akakoziqi/cwFOC/controller/README.md

# cwFOC 软件工程

## 环境搭建

开源环境搭建请参考 [这里](Docs/env.md)

## 结构划分

``` txt
build -------------- 编译中间文件（构建生成）
build_exec --------- 编译输出（构建生成）
Core --------------- 核心代码分层
    app ---------------- 应用层代码
    api ---------------- 接口层代码
    drv ---------------- 驱动层代码
    sys ---------------- 框架搭建中间层
    utl ---------------- 实用工具
Docs --------------- 相关文档
Debug -------------- 调试配置（自行获取）
Libraries ---------- MCU 驱动库（自行获取）
ThirdParty_Lib ----- 第三方库（自行获取）
```

## 调试方式

使用 pyOCD 调试
