akakoziqi/cwFOC/assets/cwFOC_sch.pdf

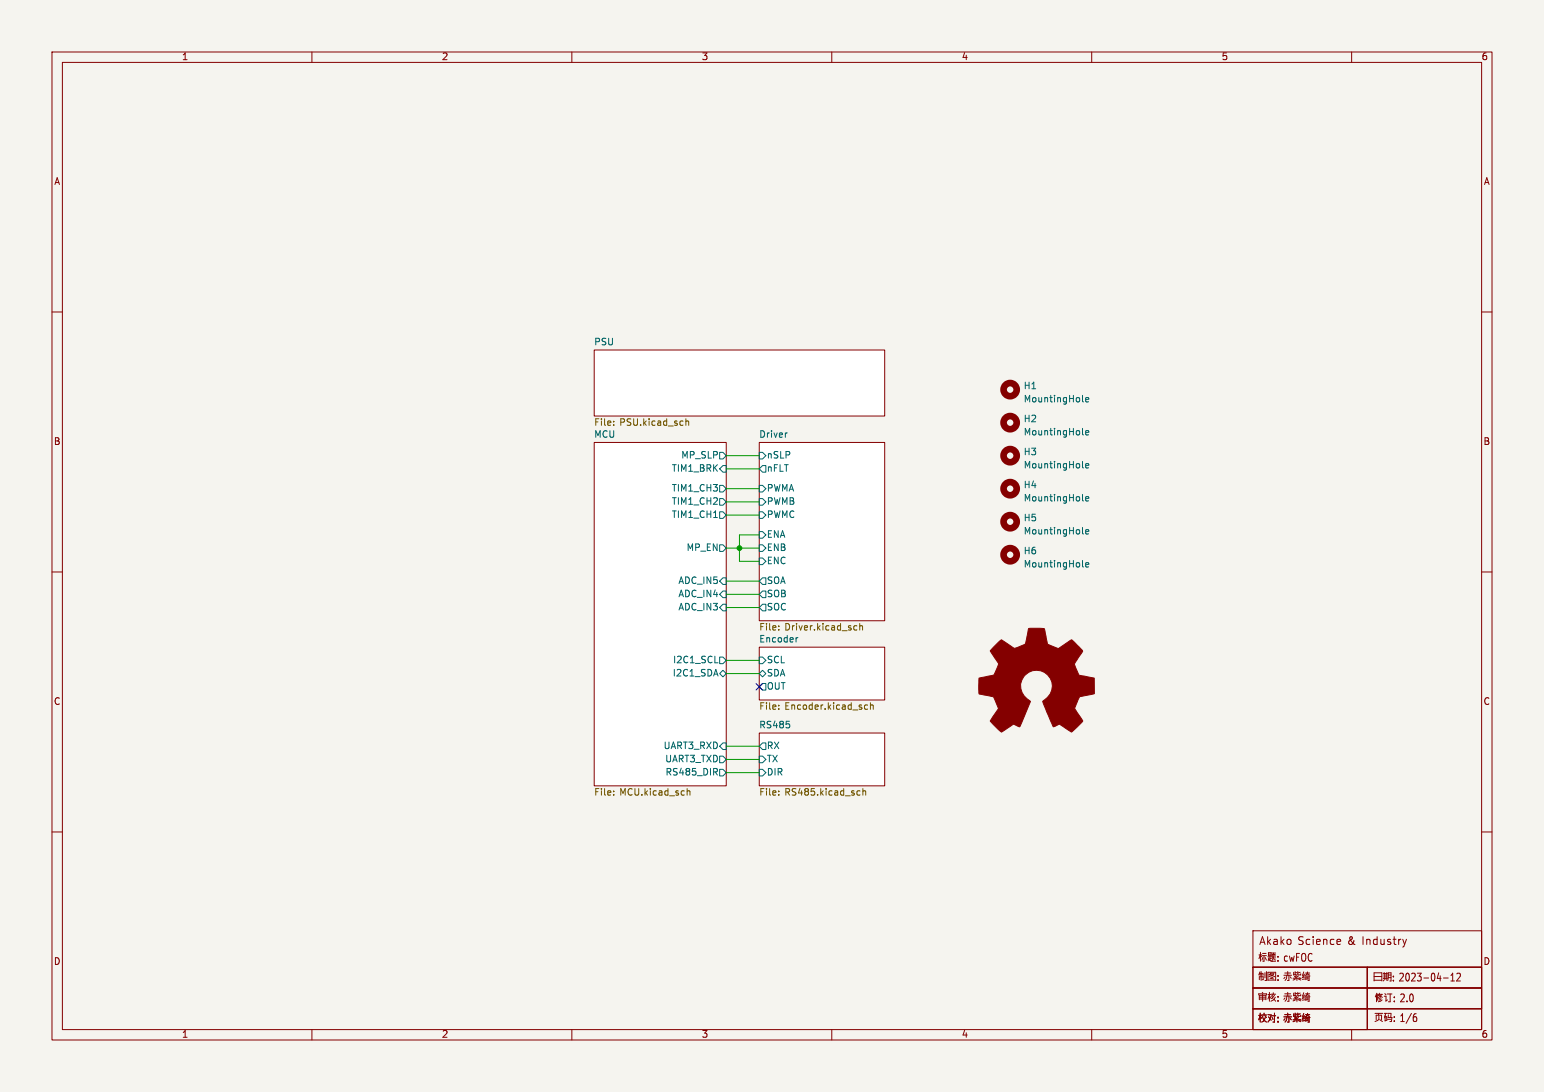
[picture p2: page 1]

RS485 File: RS485.kicad_sch OUT SCL SDA

þÿOî‹¢:2.0
þÿ˜ux:1/6

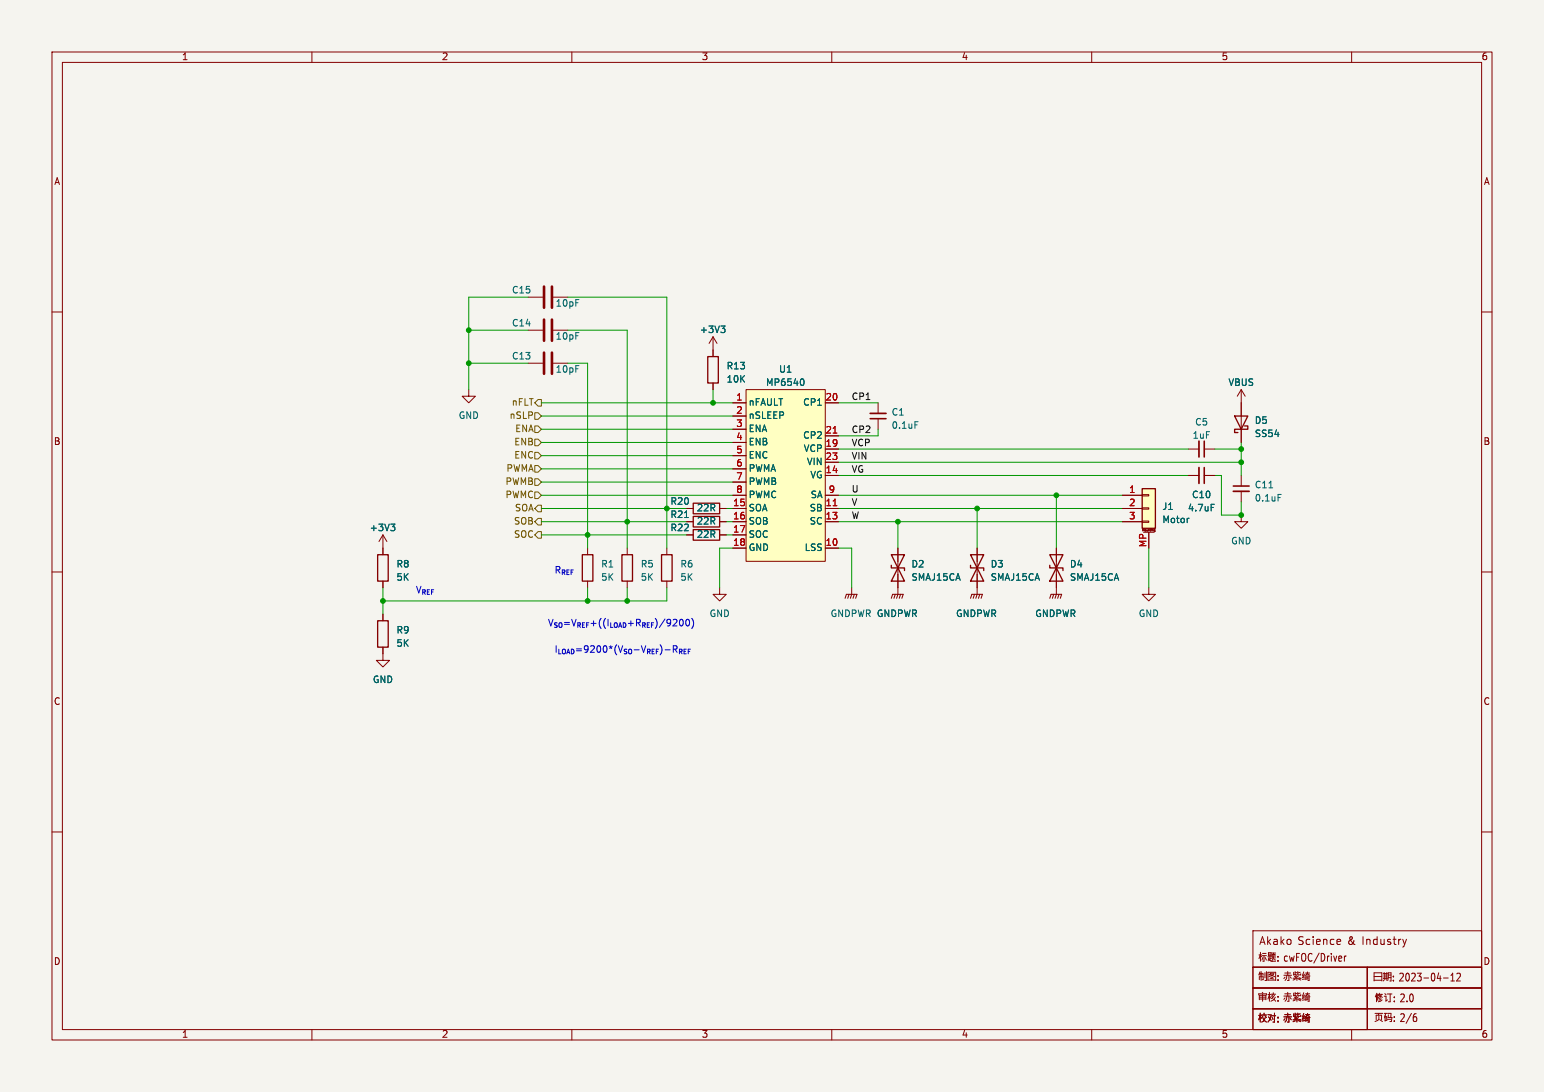
[picture p3: page 2]

22R | nSLEEP 2 ENA 3 ENB 4 ENC 5 PWMA 6 R21

2 2 | Mounting 1

V_{SO}=V_{REF}+((I_{LOAD}+R_{REF})/9200)

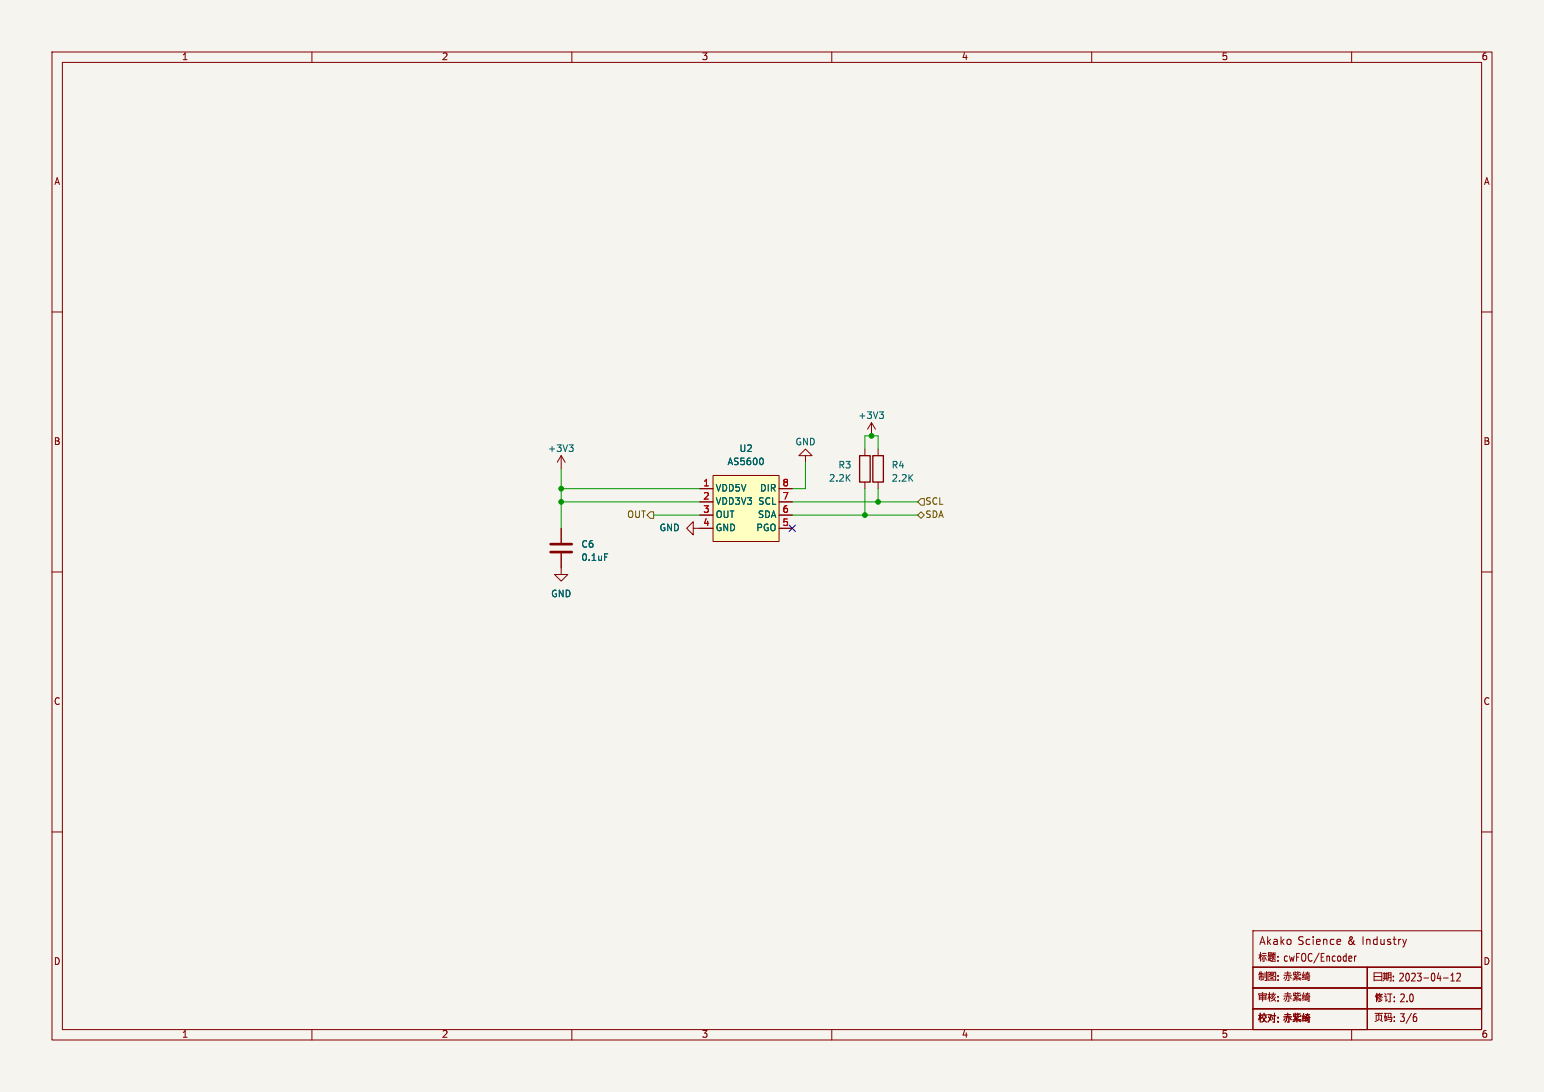
[picture p4: page 3]

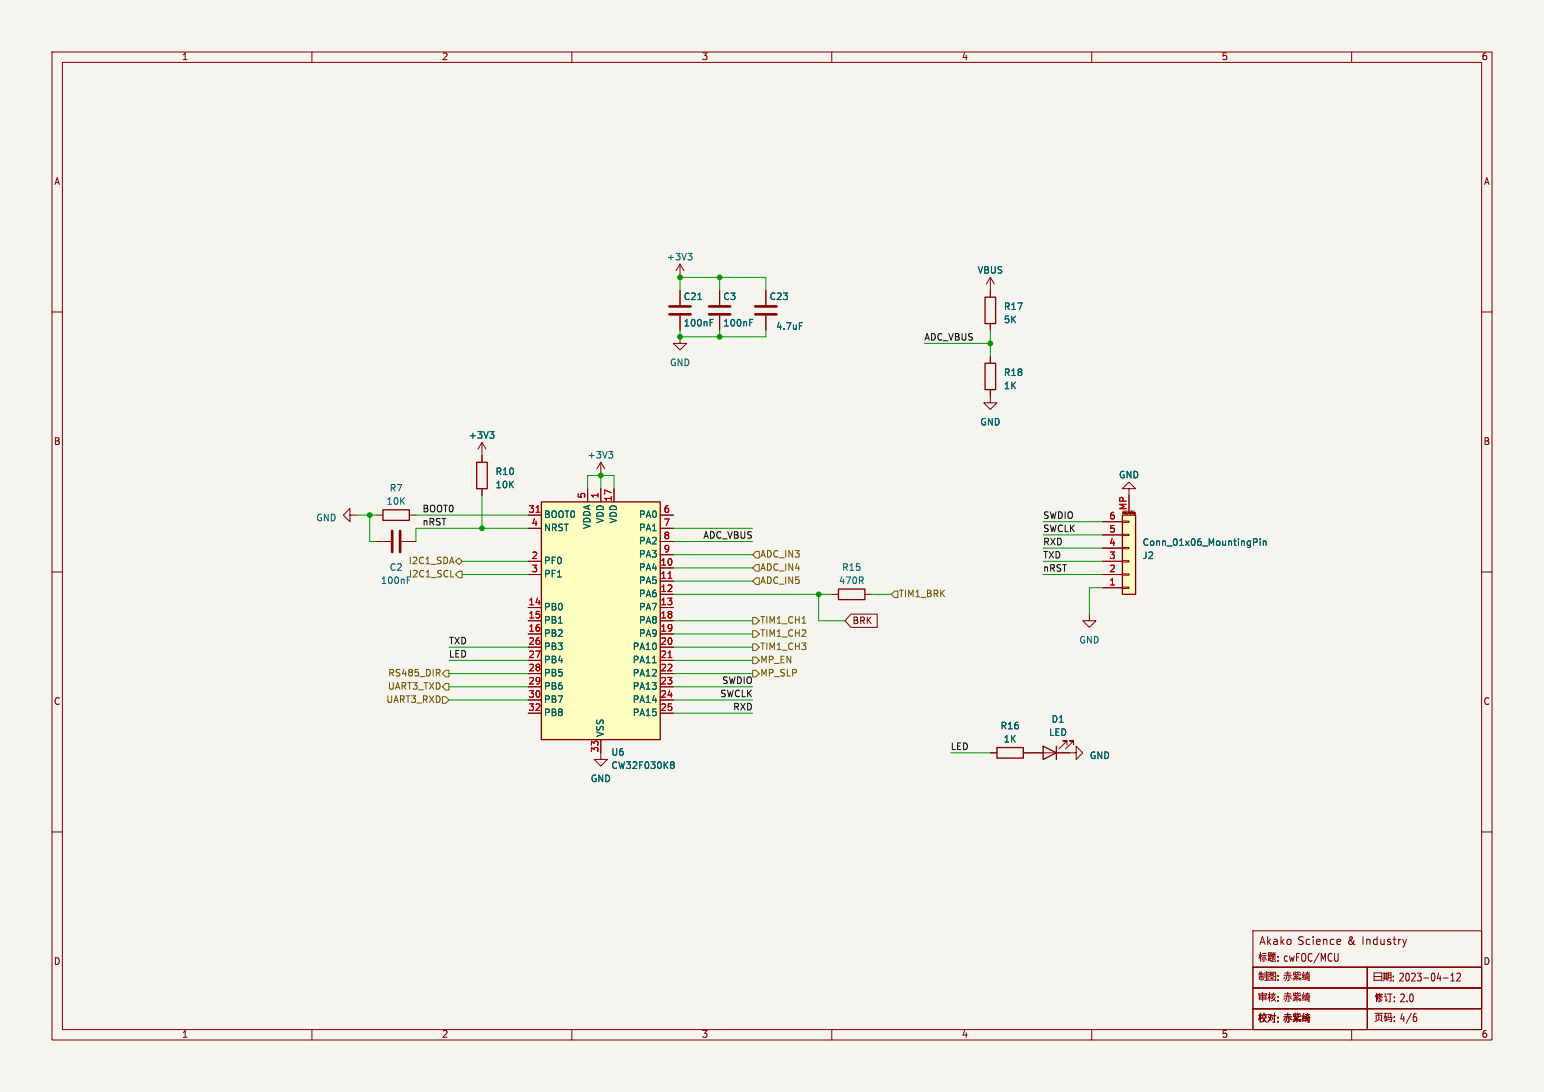
[picture p5: page 4]

1 PA4 10 PA5 11 PA6 12 PA7 13 PB0 14 PB1 15 PB2 16 VDD 17 PA8 18 PA9 19 PF0 2 PA10 20 PA11 21 PA12 22 PA13 23 PA14 24 PA15 25 PB3 26 PB4 27 PB5 28 PB6 29 PF1 3 PB7 30 BOOT0 31 PB8 32 VSS 33 NRST 4 VDDA

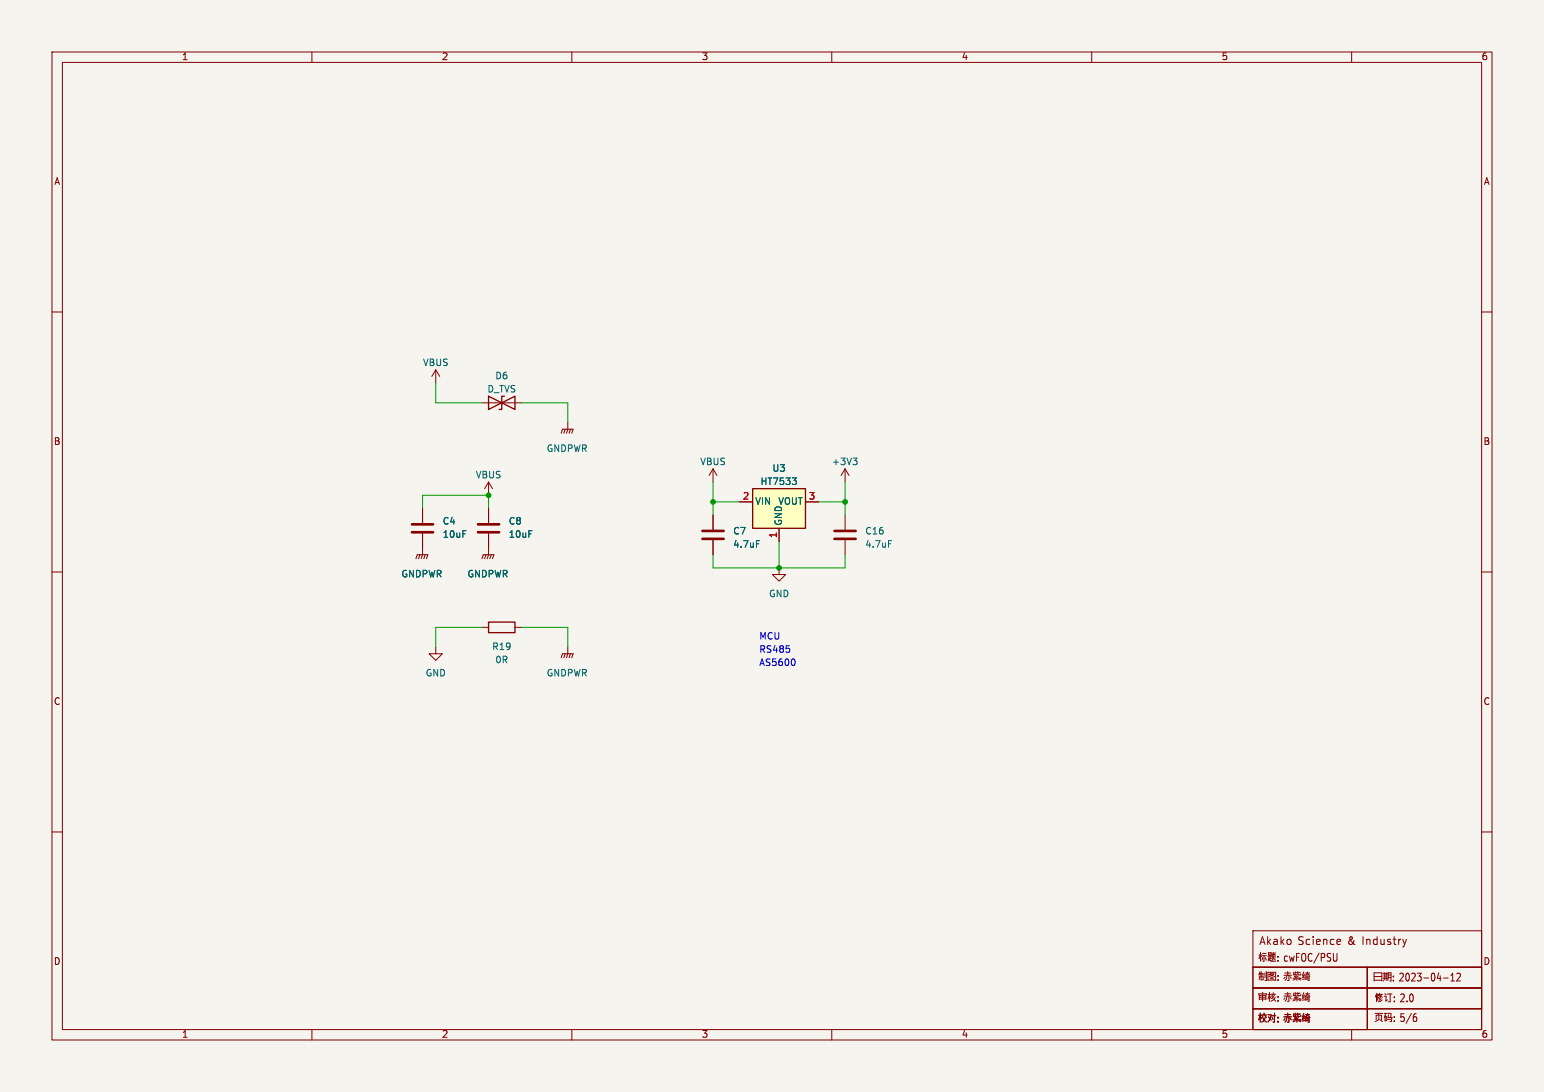
[picture p6: page 5]

1 VIN 2 VOUT 3 GNDPWR GNDPWR

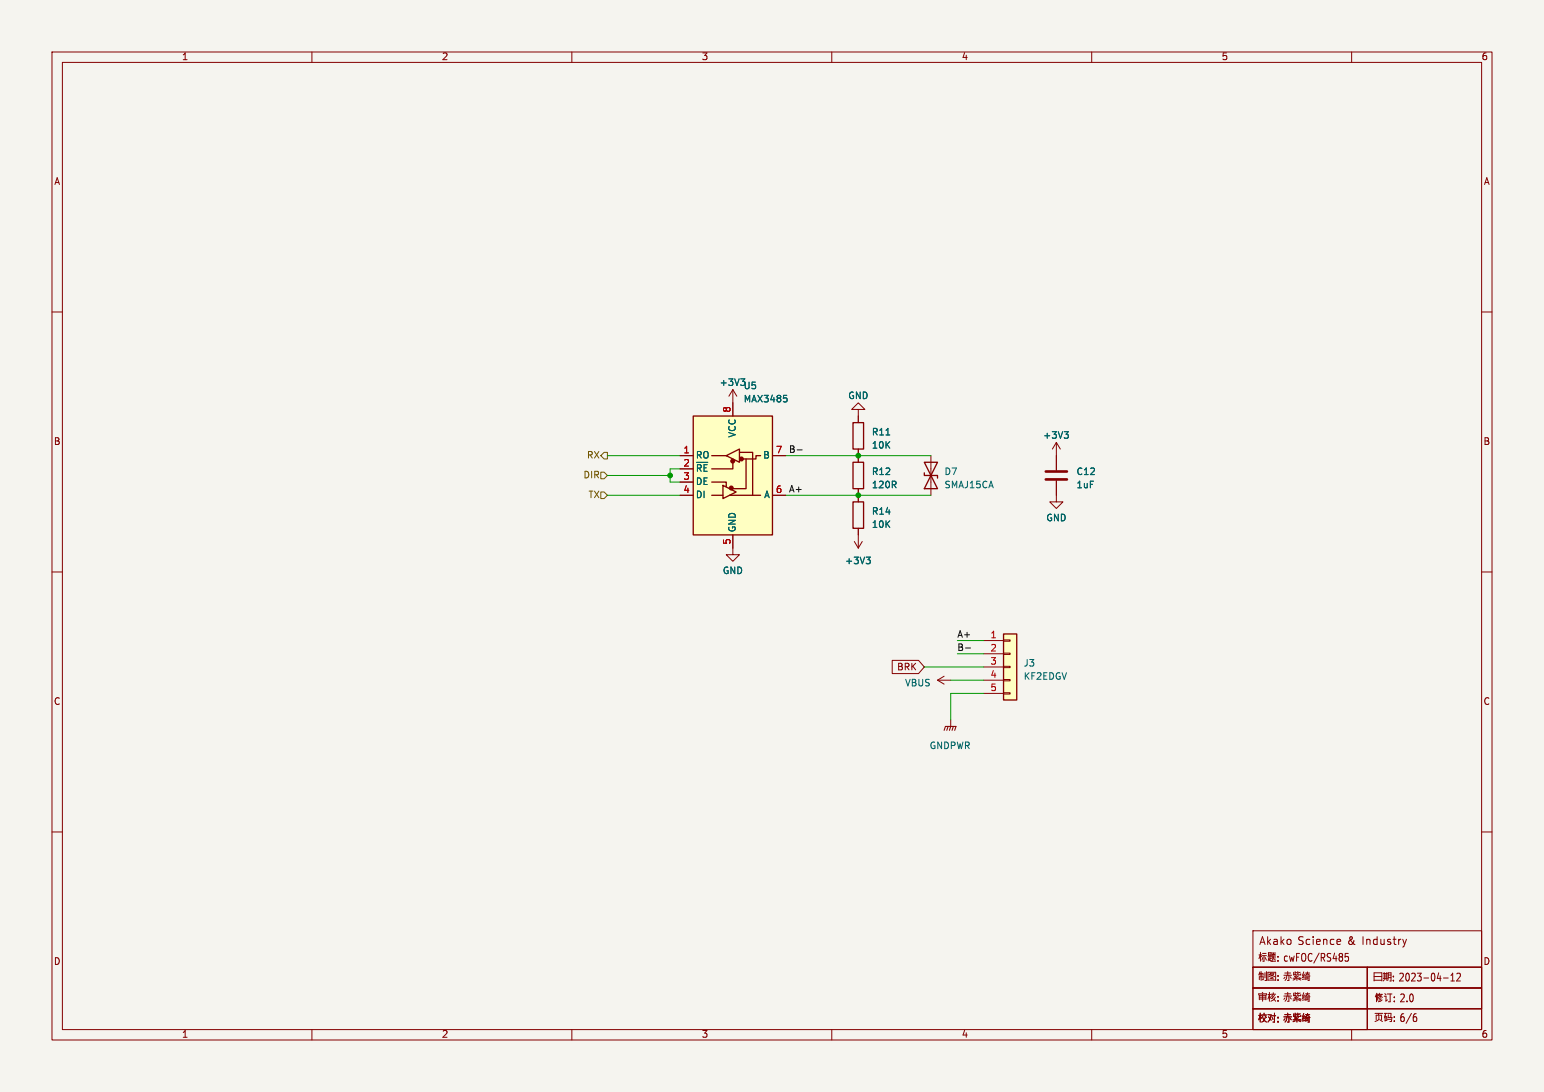
[picture p7: page 6]
