akakoziqi/cwFOC/Hardware/cwFOC.kicad_pcb

## KiCad design Hardware/cwFOC.kicad_pcb (2023-04-12)

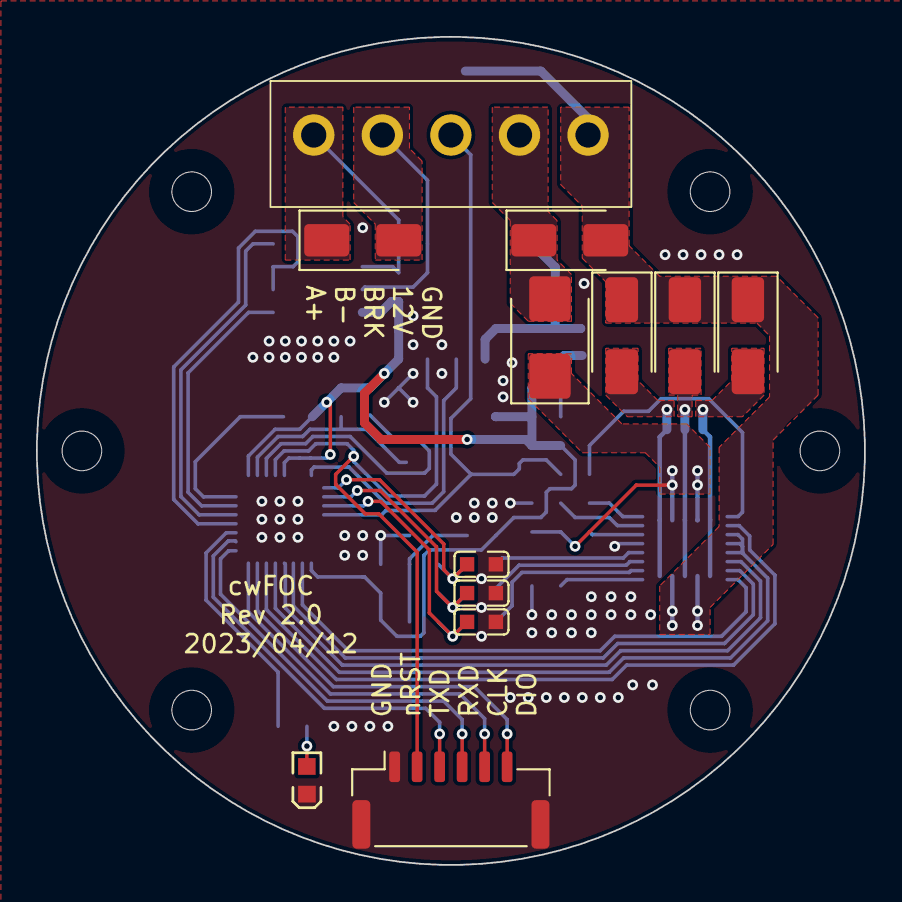
[picture p8: board cwFOC.kicad_pcb from above]

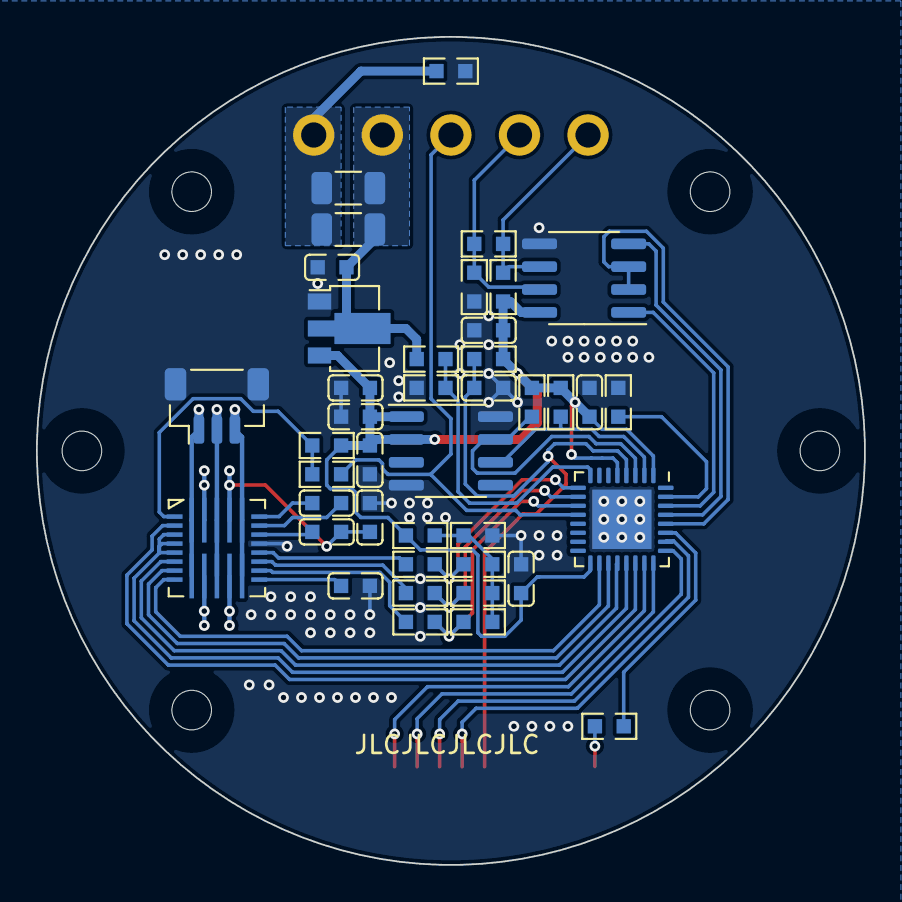
[picture p9: board cwFOC.kicad_pcb from below]

Board: 2 copper layers, 46.0 x 46.0 mm, 59 parts (41 on the bottom side), 42 nets.

Parts:
C1, C6, C11: 0.1uF; 0603_C
C2, C3, C21: 100nF; 0603_C
C4, C8: 10uF; C_1206_3216Metric
C5, C12: 1uF; 0603_C
C7, C10, C16, C23: 4.7uF; 0603_C
C13, C14, C15: 10pF; 0603_C
D1: LED; 0603_LED
D2, D3, D4, D7: SMAJ15CA; D_SMA
D5: SS54; D_SMB
D6: D_TVS; D_SMA
H1, H2, H3, H4, H5, H6: MountingHole; MountingHole_2.2mm_M2
J1: Motor; JST_SH_BM03B-SRSS-TB_1x03-1MP_P1.00mm_Vertical
J2: Conn_01x06_MountingPin; JST_GH_SM06B-GHS-TB_1x06-1MP_P1.25mm_Horizontal
J3: KF2EDGV
R1, R5, R6, R8, R9, R17: 5K; 0603_R
R3, R4: 2.2K; 0603_R
R7, R10, R11, R13, R14: 10K; 0603_R
R12: 120R; 0603_R
R15: 470R; 0603_R
R16, R18: 1K; 0603_R
R19: 0R; 0603_R
R20, R21, R22: 22R; 0603_R
U1: MP6540; QFN-26(5x5)
U2: AS5600; SOIC-8_3.9x4.9mm_P1.27mm
U3: HT7533; SOT-89-3
U5: MAX3485; SOIC-8_3.9x4.9mm_P1.27mm
U6: CW32F030K8; QFN-32-1EP_5x5mm_P0.5mm_EP3.3x3.3mm

Connections:
+3V3: C3.1, C6.2, C12.1, C16.1, C21.1, C23.1, R3.2, R4.2, R8.1, R10.2, R13.1, R14.2, U2.1 (VDD5V), U2.2 (VDD3V3), U3.3 (VOUT), U5.8 (VCC), U6.1 (VDD), U6.5 (VDDA), U6.17 (VDD)
/Driver/CP1: C1.2, U1.20 (CP1)
/Driver/CP2: C1.1, U1.21 (CP2)
/Driver/ENA: U1.3 (ENA), U1.4 (ENB), U1.5 (ENC), U6.21 (PA11)
/Driver/PWMA: U1.6 (PWMA), U6.20 (PA10)
/Driver/PWMB: U1.7 (PWMB), U6.19 (PA9)
/Driver/PWMC: U1.8 (PWMC), U6.18 (PA8)
/Driver/SOA: C15.2, R6.1, R20.1, U6.11 (PA5)
/Driver/SOB: C14.2, R5.1, R21.1, U6.10 (PA4)
/Driver/SOC: C13.2, R1.1, R22.1, U6.9 (PA3)
/Driver/U: D4.2 (A2), J1.1, U1.9 (SA), U1.26 (SA)
/Driver/V: D3.2 (A2), J1.2, U1.11 (SB), U1.24 (SB)
/Driver/VCP: C5.2, U1.19 (VCP)
/Driver/VG: C10.2, U1.14 (VG)
/Driver/W: D2.2 (A2), J1.3, U1.13 (SC), U1.22 (SC)
/Driver/nFLT: R13.2, R15.1, U1.1 (nFAULT)
/Driver/nSLP: U1.2 (nSLEEP), U6.22 (PA12)
/Encoder/SCL: R4.1, U2.7 (SCL), U6.3 (PF1)
/Encoder/SDA: R3.1, U2.6 (SDA), U6.2 (PF0)
/MCU/ADC_VBUS: R17.2, R18.1, U6.8 (PA2)
/MCU/BOOT0: R7.2, U6.31 (BOOT0)
/MCU/LED: R16.2, U6.27 (PB4)
/MCU/RS485_DIR: U5.2 (~RE), U5.3 (DE), U6.28 (PB5)
/MCU/RXD: J2.4, U6.25 (PA15)
/MCU/SWCLK: J2.5, U6.24 (PA14)
/MCU/SWDIO: J2.6, U6.23 (PA13)
/MCU/TXD: J2.3, U6.26 (PB3)
/MCU/UART3_RXD: U5.1 (RO), U6.30 (PB7)
/MCU/UART3_TXD: U5.4 (DI), U6.29 (PB6)
/MCU/nRST: C2.2, J2.2, R10.1, U6.4 (NRST)
/RS485/A+: D7.1 (A1), J3.1, R12.2, R14.1, U5.6 (A)
/RS485/B-: D7.2 (A2), J3.2, R11.2, R12.1, U5.7 (B)
BRK: J3.3, R15.2, U6.12 (PA6)
GND: C2.1, C3.2, C6.1, C7.2, C10.1, C11.2, C12.2, C13.1, C14.1, C15.1, C16.2, C21.2, C23.2, D1.1 (K), J1.MP (MountPin), J2.1, J2.MP (MountPin), R7.1, R9.2, R11.1, R18.2, R19.1, U1.18 (GND), U2.4 (GND), U2.8 (DIR), U3.1 (GND), U5.5 (GND), U6.33 (VSS)
GNDPWR: C4.2, C8.2, D2.1 (A1), D3.1 (A1), D4.1 (A1), D6.2 (A2), J3.5, R19.2, U1.10 (LSS), U1.12 (LSS)
unnamed: D1.2 (A), R16.1
unnamed: R1.2, R5.2, R6.2, R8.2, R9.1
unnamed: R20.2, U1.15 (SOA)
unnamed: R21.2, U1.16 (SOB)
unnamed: R22.2, U1.17 (SOC)
VBUS: C4.1, C7.1, C8.1, D5.2 (A), D6.1 (A1), J3.4, R17.1, U3.2 (VIN)
VIN: C5.1, C11.1, D5.1 (K), U1.23 (VIN), U1.25 (VIN)
