akakoziqi/cwFOC/Software/Core/src/interrupts_cw32f030.c

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

/* Includes ------------------------------------------------------------------*/
#include "main.h"
#include "interrupts_cw32f030.h"
/* External variables --------------------------------------------------------*/
/******************************************************************************/
/*           Cortex-M0P Processor Interruption and Exception Handlers          */
/******************************************************************************/
/**
  * @brief This function handles Non maskable interrupt.
  */
void NMI_Handler(void)
{
}

/**
  * @brief This function handles Hard fault interrupt.
  */
void HardFault_Handler(void)
{
    while (1)
    {
    }
}


/**
  * @brief This function handles System service call via SWI instruction.
  */
void SVC_Handler(void)
{
}


/**
  * @brief This function handles Pendable request for system service.
  */
void PendSV_Handler(void)
{
}


/******************************************************************************/
/* CW030 Peripheral Interrupt Handlers                                        */
/* Add here the Interrupt Handlers for the used peripherals.                  */
/* For the available peripheral interrupt handler names,                      */
/* please refer to the startup file (startup_ps030.s).                        */
/******************************************************************************/

/**
 * @brief This funcation handles WDT
 */
void WDT_IRQHandler(void)
{
    /* USER CODE BEGIN */

    /* USER CODE END */
}

/**
 * @brief This funcation handles LVD
 */
void LVD_IRQHandler(void)
{
    /* USER CODE BEGIN */

    /* USER CODE END */
}

/**
 * @brief This funcation handles RTC
 */
void RTC_IRQHandler(void)
{
    /* USER CODE BEGIN */

    /* USER CODE END */
}

/**
 * @brief This funcation handles FLASHRAM
 */
void FLASHRAM_IRQHandler(void)
{
    /* USER CODE BEGIN */

    /* USER CODE END */
}

/**
 * @brief This funcation handles RCC
 */
void RCC_IRQHandler(void)
{
    /* USER CODE BEGIN */

    /* USER CODE END */
}

/**
 * @brief This funcation handles GPIOA
 */
void GPIOA_IRQHandler(void)
{
    /* USER CODE BEGIN */

    /* USER CODE END */
}

/**
 * @brief This funcation handles GPIOB
 */
void GPIOB_IRQHandler(void)
{
    /* USER CODE BEGIN */

    /* USER CODE END */
}

/**
 * @brief This funcation handles GPIOC
 */
void GPIOC_IRQHandler(void)
{
    /* USER CODE BEGIN */

    /* USER CODE END */
}

/**
 * @brief This funcation handles GPIOF
 */
void GPIOF_IRQHandler(void)
{
    /* USER CODE BEGIN */

    /* USER CODE END */
}

/**
 * @brief This funcation handles DMACH1
 */
void DMACH1_IRQHandler(void)
{
    /* USER CODE BEGIN */

    /* USER CODE END */
}

/**
 * @brief This funcation handles DMACH23
 */
void DMACH23_IRQHandler(void)
{
    /* USER CODE BEGIN */

    /* USER CODE END */
}

/**
 * @brief This funcation handles DMA34
 */
void DMACH45_IRQHandler(void)
{
    /* USER CODE BEGIN */

    /* USER CODE END */
}

/**
 * @brief This funcation handles ADC
 */
void ADC_IRQHandler(void)
{
    /* USER CODE BEGIN */

    /* USER CODE END */
}

/**
 * @brief This funcation handles ATIM
 */
void ATIM_IRQHandler(void)
{
    /* USER CODE BEGIN */

    /* USER CODE END */
}

/**
 * @brief This funcation handles VC1
 */
void VC1_IRQHandler(void)
{
    /* USER CODE BEGIN */

    /* USER CODE END */
}

/**
 * @brief This funcation handles VC2
 */
void VC2_IRQHandler(void)
{
    /* USER CODE BEGIN */

    /* USER CODE END */
}

/**
 * @brief This funcation handles GTIM1
 */
void GTIM1_IRQHandler(void)
{
    /* USER CODE BEGIN */

    /* USER CODE END */
}

/**
 * @brief This funcation handles GTIM2
 */
void GTIM2_IRQHandler(void)
{
    /* USER CODE BEGIN */

    /* USER CODE END */
}

/**
 * @brief This funcation handles GTIM3
 */
void GTIM3_IRQHandler(void)
{
    /* USER CODE BEGIN */

    /* USER CODE END */
}

/**
 * @brief This funcation handles GTIM4
 */
void GTIM4_IRQHandler(void)
{
    /* USER CODE BEGIN */

    /* USER CODE END */
}

/**
 * @brief This funcation handles BTIM1
 */
void BTIM1_IRQHandler(void)
{
    /* USER CODE BEGIN */

    /* USER CODE END */
}

/**
 * @brief This funcation handles BTIM2
 */
void BTIM2_IRQHandler(void)
{
    /* USER CODE BEGIN */

    /* USER CODE END */
}

/**
 * @brief This funcation handles BTIM3
 */
void BTIM3_IRQHandler(void)
{
    /* USER CODE BEGIN */

    /* USER CODE END */
}

/**
 * @brief This funcation handles I2C1
 */
void I2C1_IRQHandler(void)
{
    /* USER CODE BEGIN */

    /* USER CODE END */
}

/**
 * @brief This funcation handles I2C2
 */
void I2C2_IRQHandler(void)
{
    /* USER CODE BEGIN */

    /* USER CODE END */
}

/**
 * @brief This funcation handles SPI1
 */
void SPI1_IRQHandler(void)
{
    /* USER CODE BEGIN */

    /* USER CODE END */
}

/**
 * @brief This funcation handles SPI2
 */
void SPI2_IRQHandler(void)
{
    /* USER CODE BEGIN */

    /* USER CODE END */
}

/**
 * @brief This funcation handles UART1
 */
void UART1_IRQHandler(void)
{
    /* USER CODE BEGIN */

    /* USER CODE END */
}

/**
 * @brief This funcation handles UART2
 */
void UART2_IRQHandler(void)
{
    /* USER CODE BEGIN */

    /* USER CODE END */
}

/**
 * @brief This funcation handles UART3
 */
void UART3_IRQHandler(void)
{
    /* USER CODE BEGIN */

    /* USER CODE END */
}

/**
 * @brief This funcation handles AWT
 */
void AWT_IRQHandler(void)
{
    /* USER CODE BEGIN */

    /* USER CODE END */
}

/**
 * @brief This funcation handles FAULT
 */
void FAULT_IRQHandler(void)
{
    /* USER CODE BEGIN */

    /* USER CODE END */
}



/************************ (C) COPYRIGHT CW *****END OF FILE****/
