akakoziqi/cwFOC/(commit log)

2023-03-18 创建工程
    [Driver.kicad_sch, Encoder.kicad_sch, MCU.kicad_sch, PSU.kicad_sch, Screen.kicad_sch, cwFOC.kicad_pcb, cwFOC.kicad_sch]
2023-03-18 完成原理图设计，完成初步布局布线
    [Driver.kicad_sch, Encoder.kicad_sch, MCU.kicad_sch, PSU.kicad_sch, RS485.kicad_sch, cwFOC.kicad_pcb, cwFOC.kicad_sch]
2023-03-19 完善原理图设计、添加硬件README
    [MCU.kicad_sch, Screen.kicad_sch, cwFOC.kicad_pcb, cwFOC.kicad_sch]
2023-03-19 基本完成PCB设计
    [Driver.kicad_sch, Encoder.kicad_sch, MCU.kicad_sch, PSU.kicad_sch, RS485.kicad_sch, cwFOC.kicad_pcb, cwFOC.kicad_sch]
2023-03-19 更新硬件README
2023-03-19 第一版硬件做好啦！(●'◡'●)
    [Driver.kicad_sch, Encoder.kicad_sch, MCU.kicad_sch, PSU.kicad_sch, RS485.kicad_sch, cwFOC.kicad_pcb, cwFOC.kicad_sch]
2023-03-23 添加api_logs
2023-03-24 软件添加调试串口，RS485，电机驱动，完成初步功能验证
2023-03-25 修改硬件计划
2023-03-25 添加foc，adc支持，主频更改为64MHz，完成as5600驱动
2023-03-26 调整第二版原理图
    [Driver.kicad_sch, MCU.kicad_sch, cwFOC.kicad_pcb]
2023-04-02 小修小补，拉了点线
    [Driver.kicad_sch, Encoder.kicad_sch, MCU.kicad_sch, PSU.kicad_sch, RS485.kicad_sch, cwFOC.kicad_pcb, cwFOC.kicad_sch]
2023-04-12 完成第二版硬件
    [Encoder.kicad_sch, MCU.kicad_sch, PSU.kicad_sch, RS485.kicad_sch, cwFOC.kicad_pcb, cwFOC.kicad_sch]
2023-04-12 更新 README
2023-04-12 添加环境搭建 README
2023-04-12 完善图纸和 README
    [Driver.kicad_sch, Encoder.kicad_sch, MCU.kicad_sch, PSU.kicad_sch, RS485.kicad_sch, cwFOC.kicad_sch]
2023-04-13 添加许可证，调整项目结构
2023-04-23 添加定点数计算优化
