akakoziqi/cwFOC/(notices)

Notices in the files:
Software/Core/src/interrupts_cw32f030.c:
© Copyright (c) 2021 CW.
All rights reserved.
controller/Core/app/app_foc.c:
modify it under the terms of the GNU General Public License
README.md:
License: GPL-v2
